Dakshankarthic/hexa/(commit log)

2026-05-26 Update rule book with custom servo labels
2026-09-12 feat: dual-PCA9685 18-servo controller (0x40 Right, 0x43 Left), direct PWM ticks, and Android app
2026-09-24 docs: update rule book with dual SMPS power evaluation, inrush stall diagnostics, and I2C wiring fixes
